AliElbaradie/5DOF-Plant-Scanning-System/images/nema23_stepper_motor_y.jpg

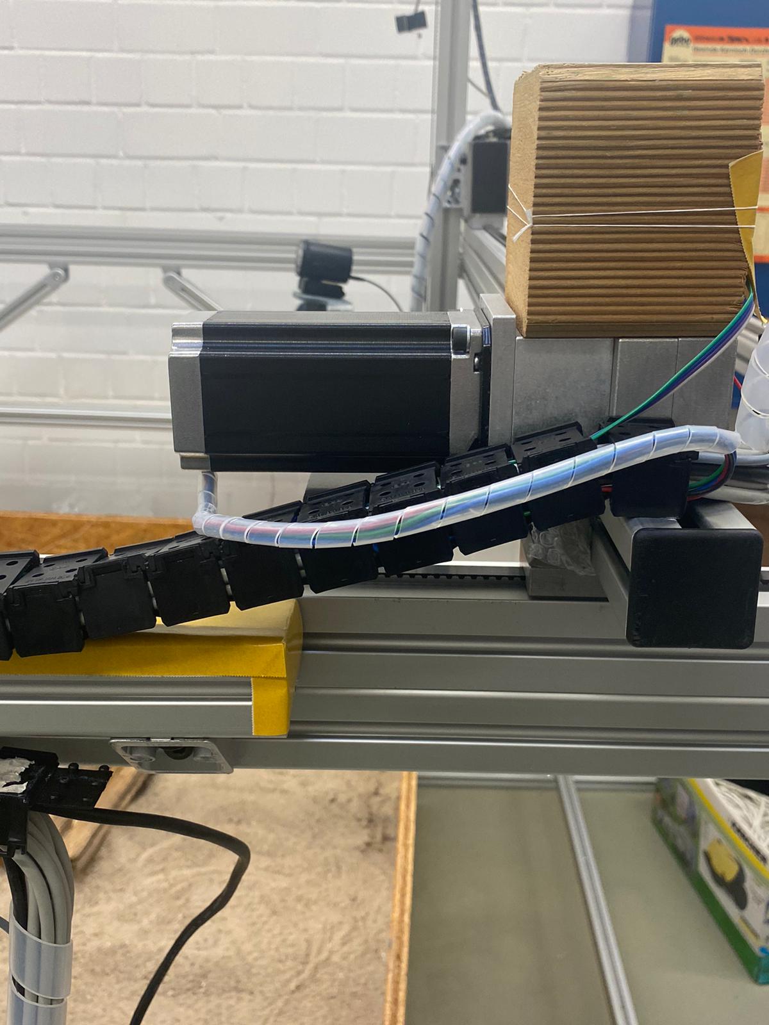
images/nema23_stepper_motor_y.jpg
