AliElbaradie/5DOF-Plant-Scanning-System/(commit log)

2026-07-14 Revise README for 5DOF Camera Control System
    Updated project title and overview to reflect the new focus on an automated camera control system. Added detailed contributions and responsibilities, along with updated hardware and documentation sections.
2026-07-14 Rename project to 5DOF Plant Scanning System
    Updated project title and description to reflect the change from an automated camera control system to a plant scanning system. Adjusted sections for clarity and accuracy regarding system components and contributions.
2026-07-15 Correct link case for project report PDF
